siewwentong/Warman-Competition/README.md

# Warman-Competition

The purpose of this project was to serve as an entry for the Warman Competition 2019 as part of our coursework under the unit MEC2402: Design 1 for BEng. Mechatronics Engineering in Monash, given RM200 budget. Our device participated in the competition held on Week 11 and scored 90 points and 49.5 points for the first and second runs respectively. These scores were attained by collecting 20 balls and 11 balls throughout the two rounds. The two Early Bird challenges of 100% and 75% the device took part in accumulated 85 points and 188.25 points respectively.

Video of the device collecting and depositing all 20 balls within 35 seconds: https://youtu.be/fWXprGKRnV4
