siewwentong/Warman-Competition/technical_drawings/Indented Pinion.PDF

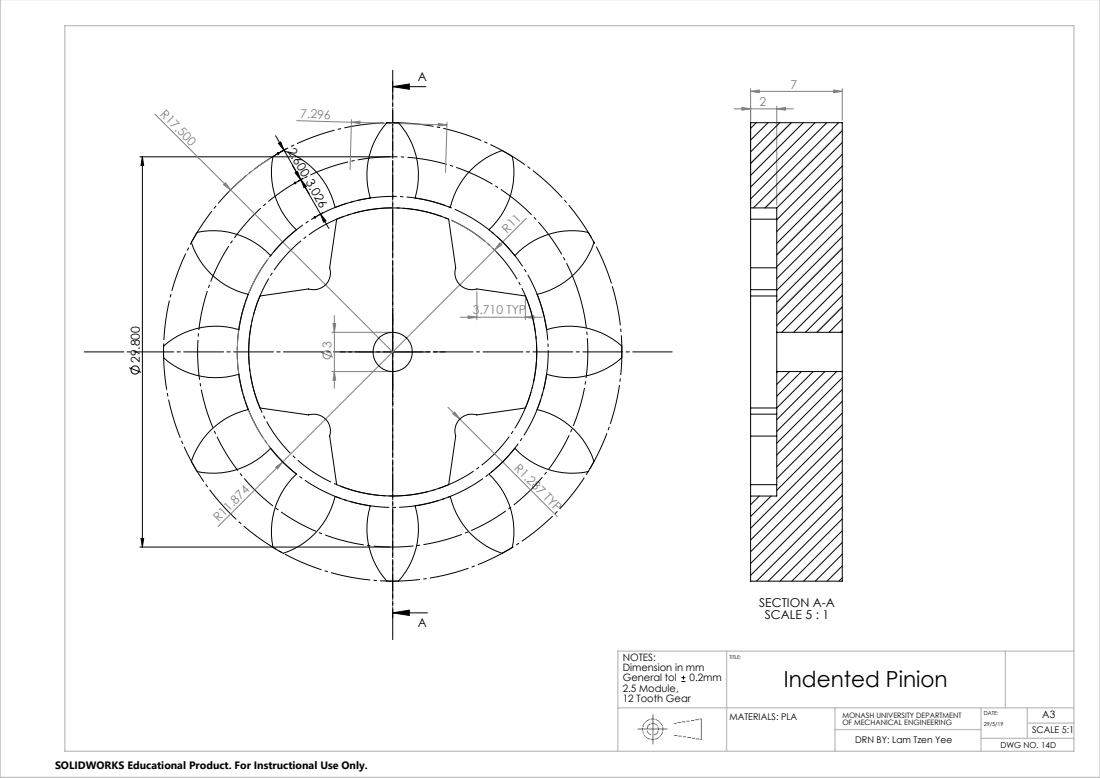
[picture p16: page 1]
R1.287 TYP; 3.710 TYP; SECTION A-A SCALE 5 : 1; DWG NO. 14D; SCALE 5:1; General tol

NOTES: Dimension in mm 2.5 Module, 12 Tooth Gear | TITLE: Indented Pinion

MATERIALS: PLA | MONASH UNIVERSITY DEPARTMENT OF MECHANICAL ENGINEERING | DATE: 29/5/19 | A3

DRN BY: Lam Tzen Yee

SOLIDWORKS Educational Product. For Instructional Use Only.
