siewwentong/Warman-Competition/technical_drawings/Rack Arm.PDF

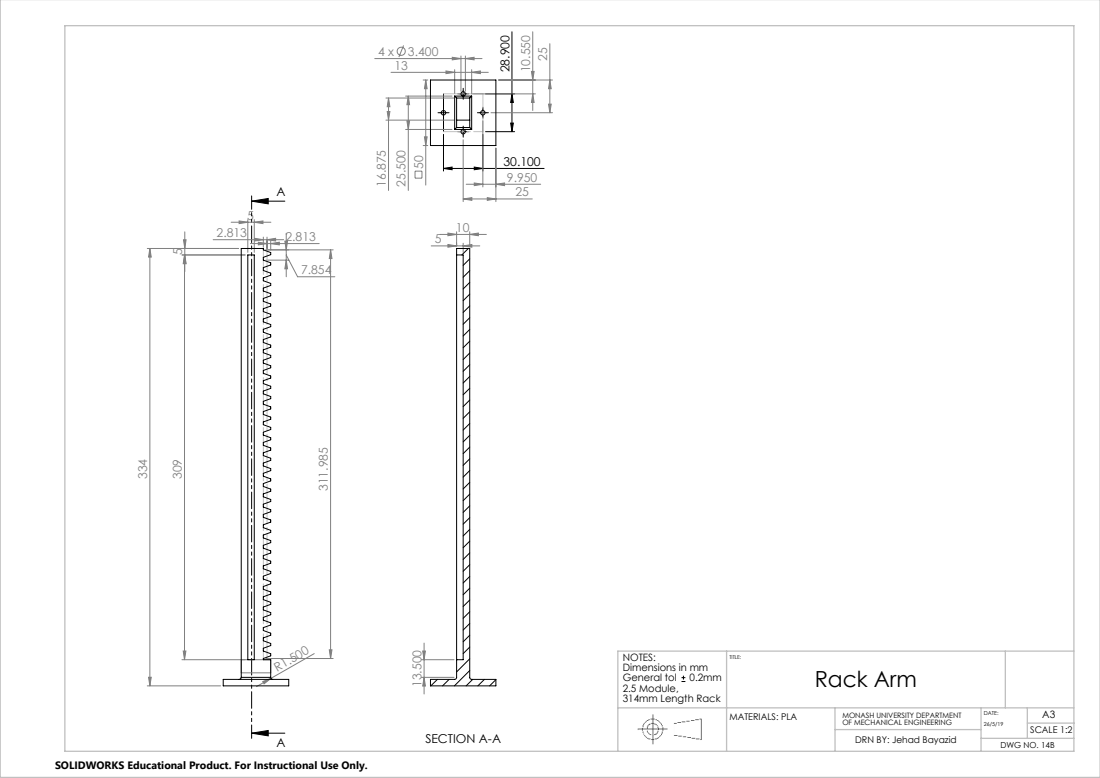
[picture p17: page 1]
SECTION A-A; DWG NO. 14B; SCALE 1:2; General tol

NOTES: Dimensions in mm 2.5 Module, 314mm Length Rack | TITLE: Rack Arm

MATERIALS: PLA | MONASH UNIVERSITY DEPARTMENT OF MECHANICAL ENGINEERING | DATE: 26/5/19 | A3

DRN BY: Jehad Bayazid

SOLIDWORKS Educational Product. For Instructional Use Only.
