siewwentong/Warman-Competition/technical_drawings/Scoop.PDF

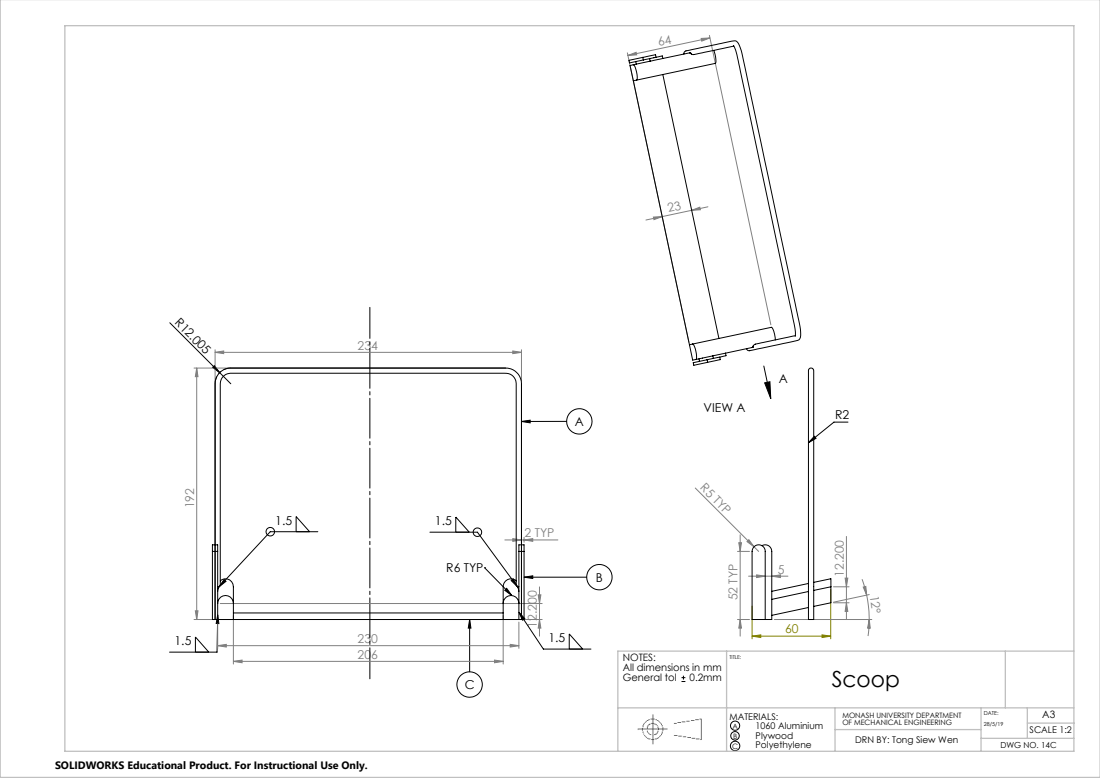
[picture p18: page 1]
2 TYP; R6 TYP; 52 TYP; R5 TYP; VIEW A; DWG NO. 14C; SCALE 1:2; General tol

230
206

NOTES: All dimensions in mm | TITLE: Scoop

MATERIALS: A 1060 Aluminium Plywood B Polyethylene C | MONASH UNIVERSITY DEPARTMENT OF MECHANICAL ENGINEERING | DATE: 28/5/19 | A3

DRN BY: Tong Siew Wen

SOLIDWORKS Educational Product. For Instructional Use Only.
