siewwentong/Warman-Competition/technical_drawings/Servo Bracket.PDF

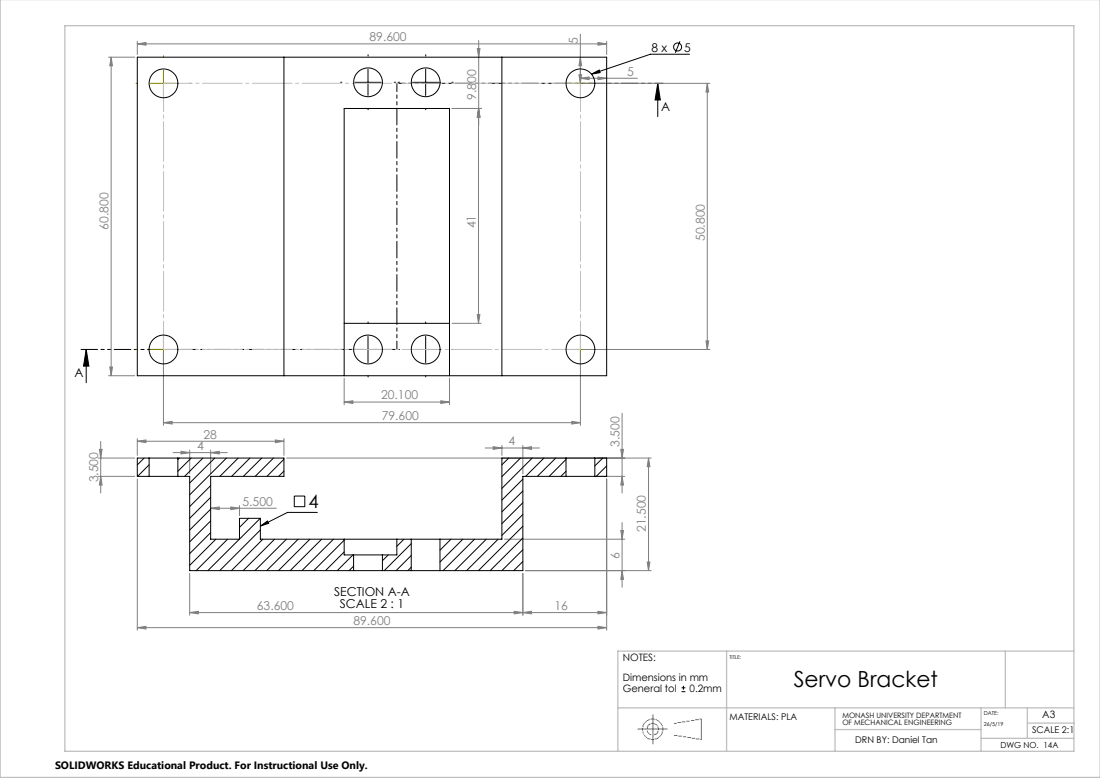
[picture p19: page 1]
SECTION A-A SCALE 2 : 1; DWG NO. 14A; SCALE 2:1; General tol

NOTES: Dimensions in mm | TITLE: Servo Bracket

MATERIALS: PLA | MONASH UNIVERSITY DEPARTMENT OF MECHANICAL ENGINEERING | DATE: 26/5/19 | A3

DRN BY: Daniel Tan

SOLIDWORKS Educational Product. For Instructional Use Only.
